jinchan1203/f1tenth-car-build/hardware/upper_plate_orin_nx_v2/F1tenth_Orin_NX_v2.stl

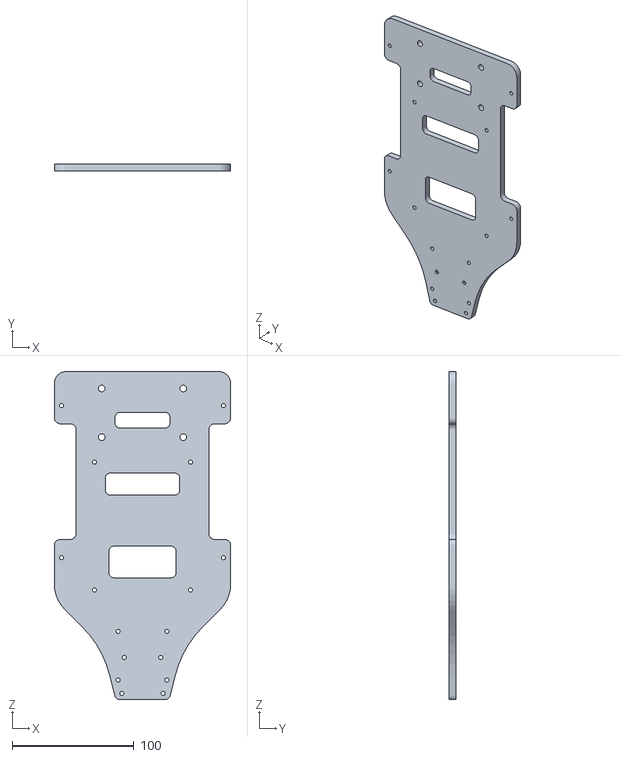
[picture p3: CAD file, 2026-11-03]
hardware/upper_plate_orin_nx_v2/F1tenth_Orin_NX_v2.stl
145.0 x 5.50 x 269.5
