jinchan1203/f1tenth-car-build/hardware/upper_plate_orin_nx_v2/print/upper_plate_v2_PETG-CF.3mf

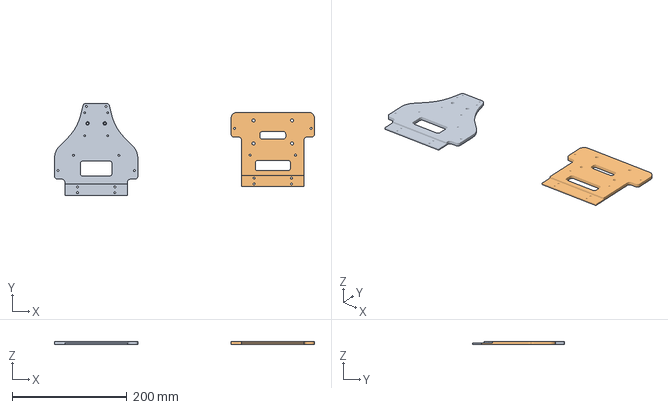
[picture p4: CAD file, 2026-11-03]
hardware/upper_plate_orin_nx_v2/print/upper_plate_v2_PETG-CF.3mf
452.2 x 159.8 x 5.50 mm
print_v2_A_front.stl
print_v2_B_rear.stl
