jinchan1203/f1tenth-car-build/hardware/upper_plate_orin_nx_v2/split/F1tenth_Orin_NX_v2_B_rear.stl

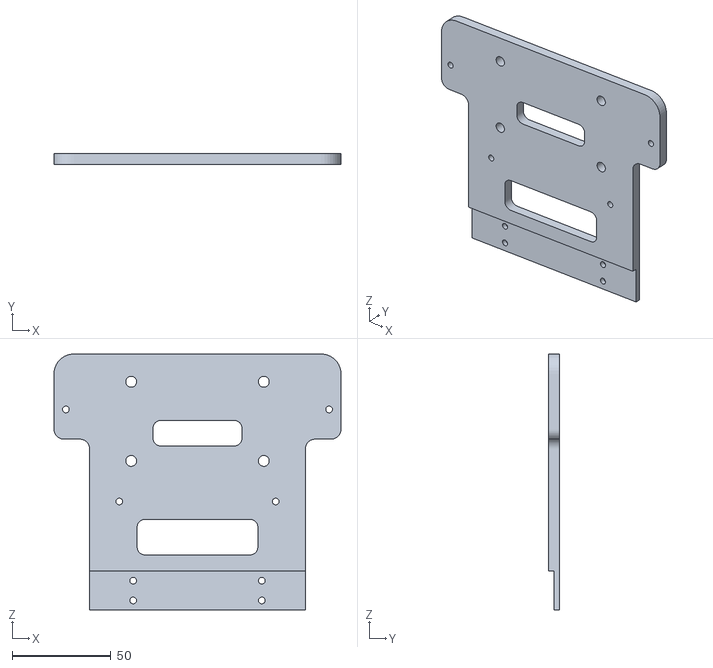
[picture p6: CAD file, 2026-11-03]
hardware/upper_plate_orin_nx_v2/split/F1tenth_Orin_NX_v2_B_rear.stl
145.0 x 5.50 x 129.3
