jinchan1203/f1tenth-car-build/hardware/upper_plate_orin_nx/original/F1tenth_Orin_NX.stl

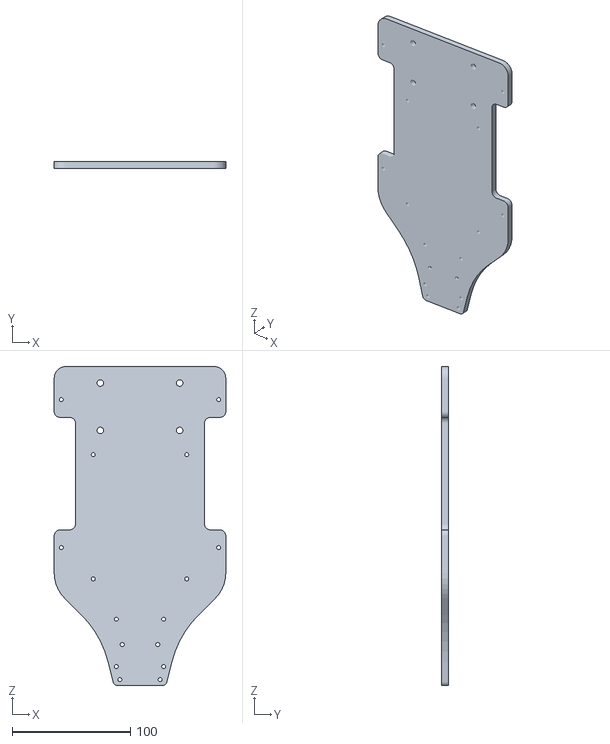
[picture p7: CAD file, 2026-11-03, an earlier design]
hardware/upper_plate_orin_nx/original/F1tenth_Orin_NX.stl
145.0 x 5.50 x 269.5
