jinchan1203/f1tenth-car-build/hardware/upper_plate_orin_nx/print/upper_plate_B_rear_PETG-CF.3mf

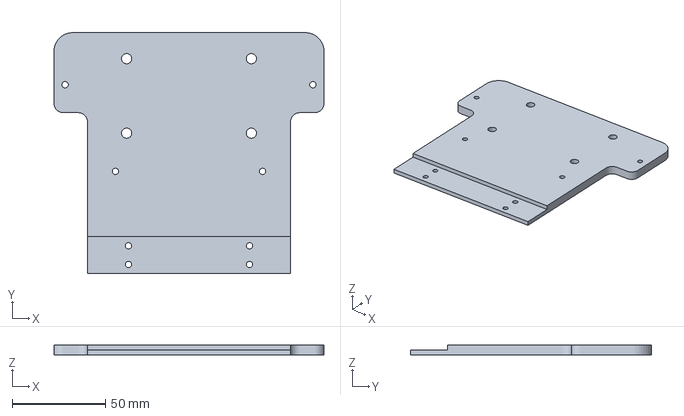
[picture p8: CAD file, 2026-11-03, an earlier design]
hardware/upper_plate_orin_nx/print/upper_plate_B_rear_PETG-CF.3mf
145.0 x 129.3 x 5.50 mm
