jinchan1203/f1tenth-car-build/hardware/upper_plate_orin_nx/print/print_A_front.stl

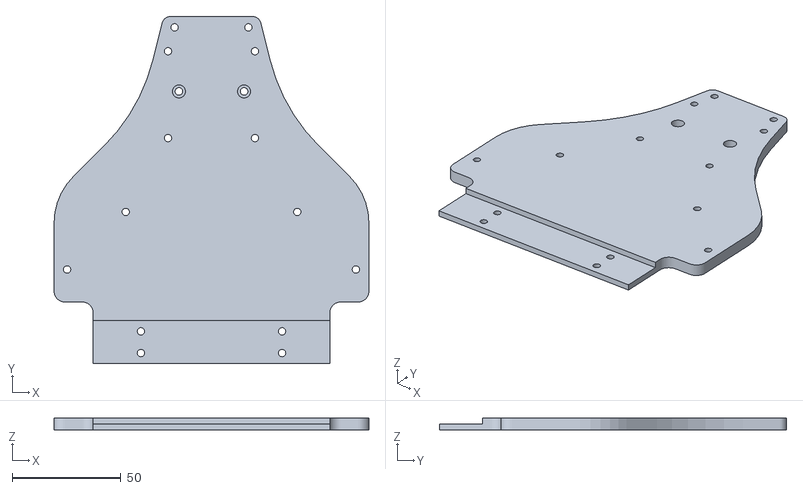
[picture p9: CAD file, 2026-11-03, an earlier design]
hardware/upper_plate_orin_nx/print/print_A_front.stl
145.0 x 159.8 x 5.50
