jinchan1203/f1tenth-car-build/hardware/upper_plate_orin_nx/print/upper_plate_PETG-CF.3mf

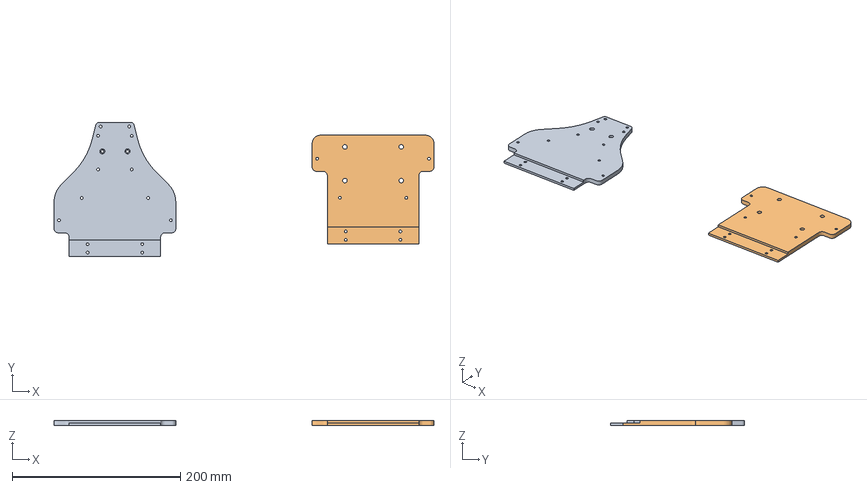
[picture p10: CAD file, 2026-11-03, an earlier design]
hardware/upper_plate_orin_nx/print/upper_plate_PETG-CF.3mf
452.2 x 159.8 x 5.50 mm
print_A_front.stl
print_B_rear.stl
