jinchan1203/f1tenth-car-build/(list of files, cad)

Other CAD files:
hardware/upper_plate_orin_nx_v2/print/print_v2_A_front.stl
hardware/upper_plate_orin_nx_v2/print/print_v2_B_rear.stl
hardware/upper_plate_orin_nx/split/F1tenth_Orin_NX_B_rear.stl
hardware/upper_plate_orin_nx/split/F1tenth_Orin_NX_A_front.stl
hardware/upper_plate_orin_nx/print/print_B_rear.stl
