jinchan1203/f1tenth-car-build/(commit log)

2026-11-03 F1TENTH 실차 제작: Traxxas + Orin NX 상판 분할·3D 프린팅, 조립 가이드 요약, 부품 확인 사항
    - UNICORN Racing F1tenth_Orin_NX 상판(CC BY 4.0)을 256mm 베드용 하프랩 2분할 + M3 볼트 구멍
    - 출력용 STL(방향 보정), Bambu X2D PETG-CF 프로젝트, 분할·분석·프리셋 스크립트
    - RoboRacer 공식 조립 가이드 한국어 요약, 배터리(2S→3S)·스탠드오프 확인 사항
    [F1tenth_Orin_NX.stl, F1tenth_Orin_NX_A_front.stl, F1tenth_Orin_NX_B_rear.stl, print_A_front.stl, print_B_rear.stl, upper_plate_B_rear_PETG-CF.3mf, upper_plate_PETG-CF.3mf]
2026-11-03 부품 추정 반영: VESC 6 MkVI(3S~12S) → 3S 배터리 필요, LiDAR Hokuyo 계열
2026-11-03 상판 v2: 케이블 통과용 네모 창 3개 (설계·분할·슬라이스 검증, 미출력)
    [F1tenth_Orin_NX_v2.stl, F1tenth_Orin_NX_v2_A_front.stl, F1tenth_Orin_NX_v2_B_rear.stl, print_v2_A_front.stl, print_v2_B_rear.stl, upper_plate_v2_PETG-CF.3mf]
2026-11-03 진행 상황: v1 상판 결합 완료
2026-11-10 차체를 Traxxas Rally로 정정
2026-11-10 tools/split_deck.py: 구멍을 피해 자를 위치 자동 탐색하는 하프랩 분할 (공식 데크 V3용)
